Insyte-Technology/EFRO_Breast_Cancer_Detection/Minimal_Prototype_Function_Generator_V0.1/Minimal_Prototype_Function_Generator_V0.1.kicad_pcb

## KiCad design Minimal_Prototype_Function_Generator_V0.1/Minimal_Prototype_Function_Generator_V0.1.kicad_pcb (2025-12-15)

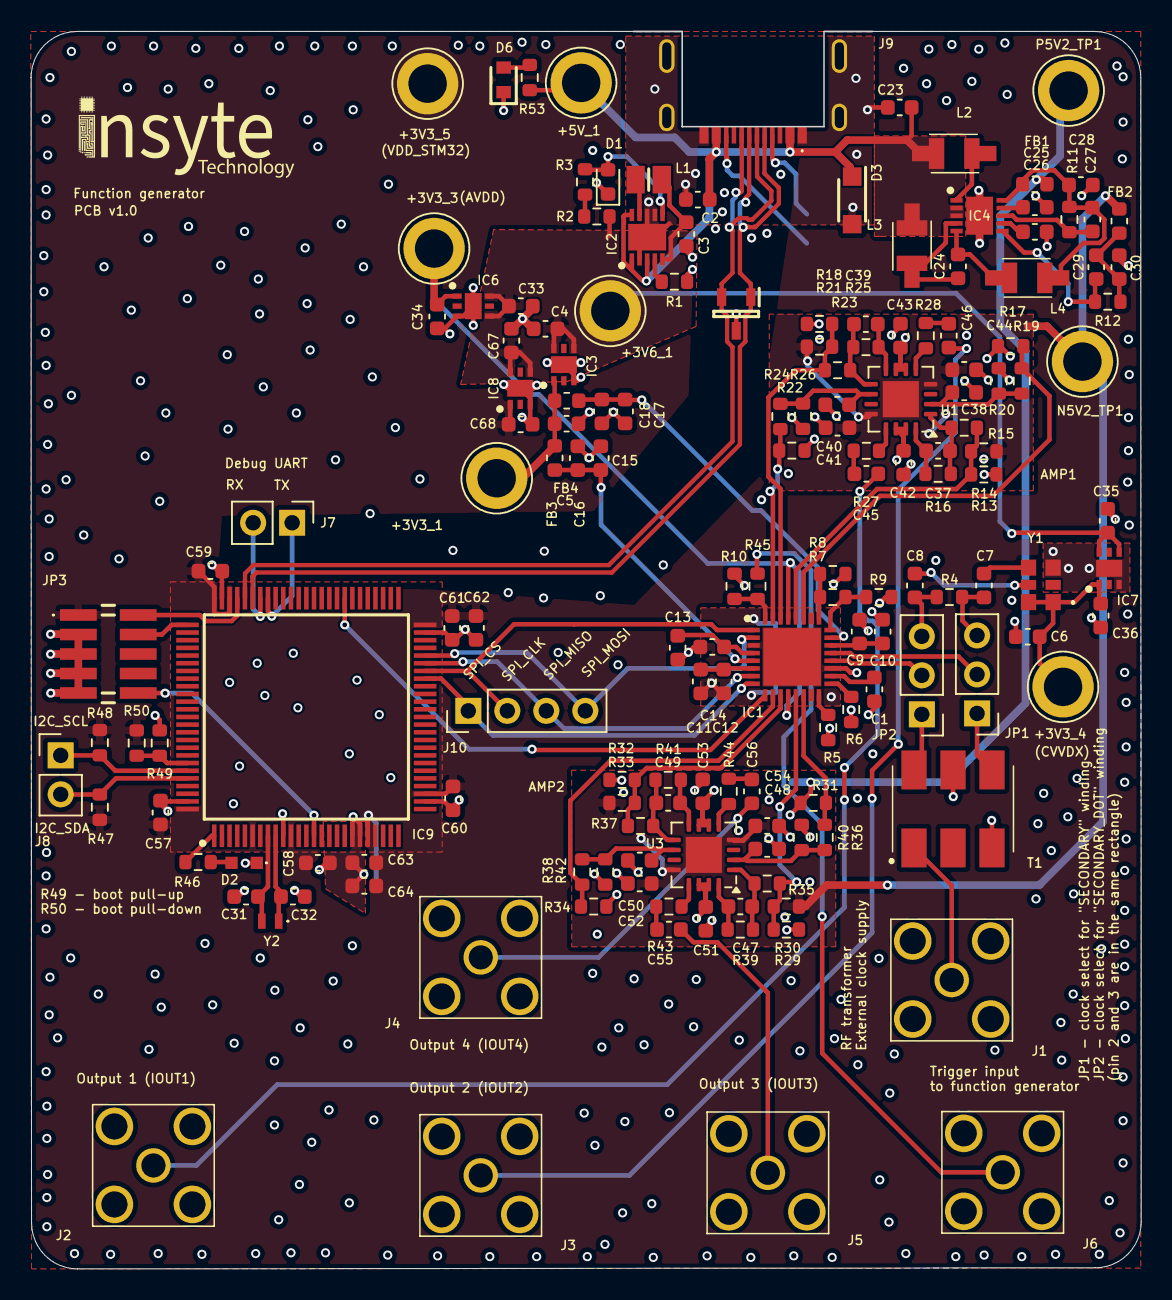
[picture p1: board Minimal_Prototype_Function_Generator_V0.1.kicad_pcb from above]

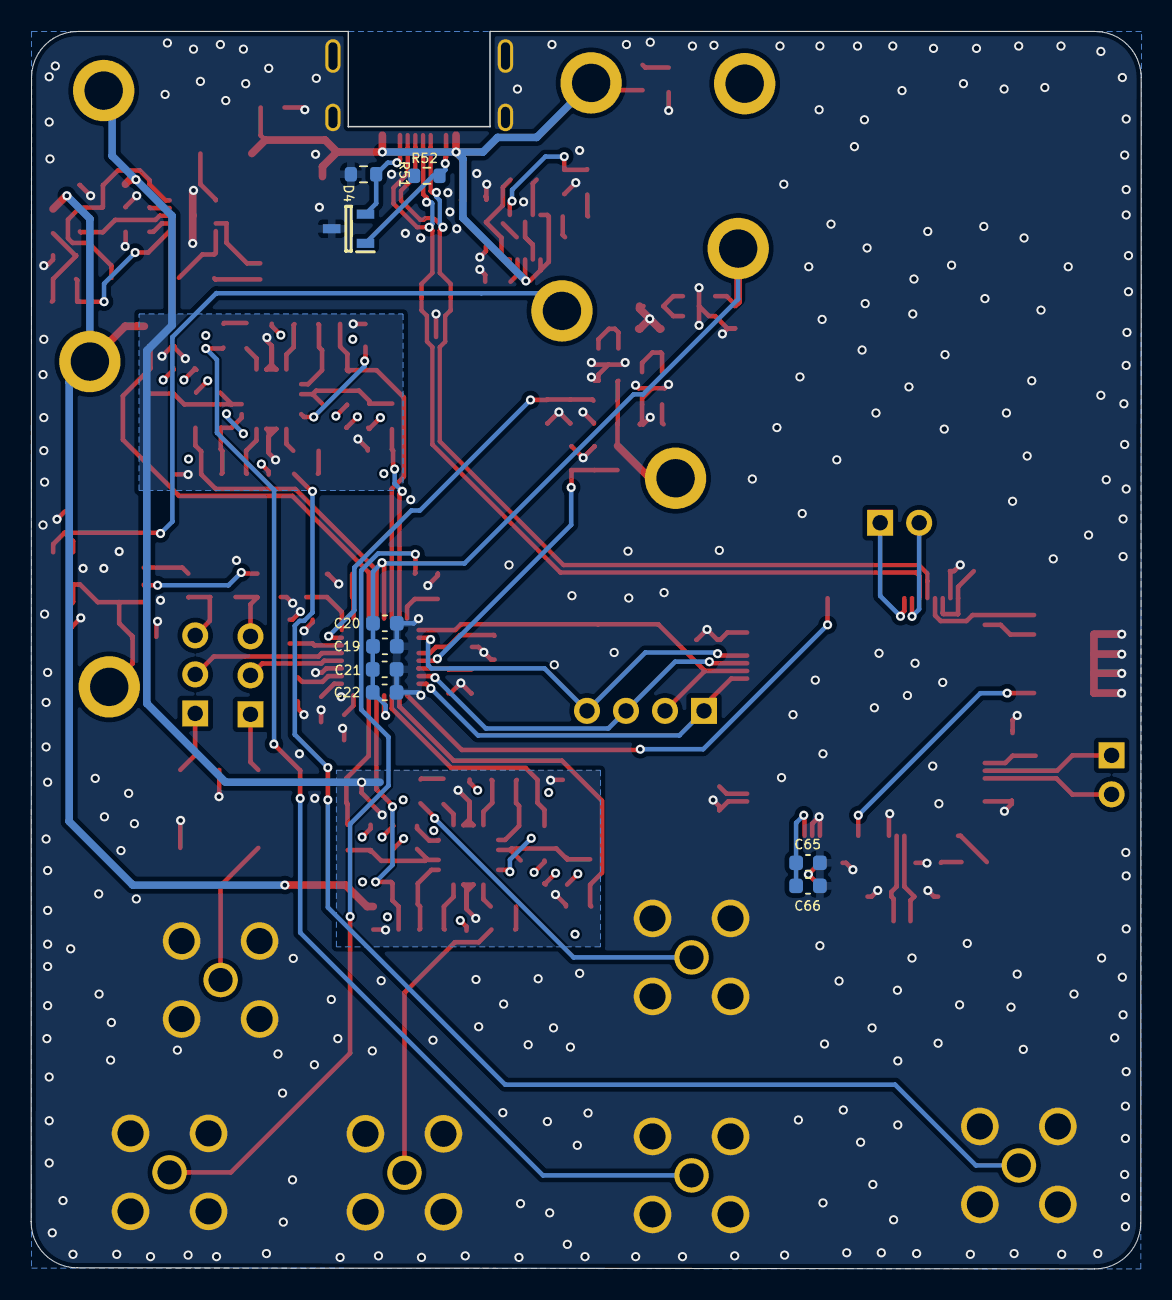
[picture p2: board Minimal_Prototype_Function_Generator_V0.1.kicad_pcb from below]

Board: 4 copper layers, 72.3 x 80.6 mm, 170 parts (9 on the bottom side), 97 nets.

Parts:
+3V3_1, +3V3_3, +3V3_4, +3V3_5, +3V6_1, +5V_1: TestPoint; TestPoint_Loop_D3.80mm_Drill2.5mm
C1, C6, C7, C8, C9, C11, C13, C15, C17, C19, C21, C25, C26, C41, C42, C43, C44, C51, C52, C53, C54: 0.1uF; C_0603_1608Metric
C2, C3: 10uF; C_0603_1608Metric
C4, C5, C33, C34, C35, C36, C67, C68: 4.7uF; C_0603_1608Metric
C10, C12, C16, C18, C20, C22: 100pF; C_0603_1608Metric
C14: 0.01uF; C_0603_1608Metric
C23, C28, C30: 2.2uF; C_0603_1608Metric
C24, C45, C46, C55, C56: 1uF; C_0603_1608Metric
C27: 4.7pF; C_0603_1608Metric
C29: 10pF; C_0603_1608Metric
C31, C32: 8pF C0G/NP0 >5%; C_0603_1608Metric
C37, C38, C39, C40, C47, C48, C49, C50: 1.5pF; C_0603_1608Metric
C57, C58, C59, C60, C61, C65: 0.1u; C_0603_1608Metric
C62: 4.7u; C_0603_1608Metric
C63: 0.01u; C_0603_1608Metric
C64, C66: 1u; C_0603_1608Metric
D1: LED GREEN; LED_0603_1608Metric
D2: CSL1901MW1
D3: SMF5.0A; SODFL3618X110N
D4, D5: SM05.TCT; SOT95P237X125-3N
D6: APT1608LZGCK; LEDC1608X85N
FB1, FB2, FB3, FB4: 1.8K OHM AT 100MEGHZ; L_0603_1608Metric
IC1: AD9106BCPZ; QFN50P500X500X80-33N-D
IC2: ADP5300ACPZ-1-R7; SON50P300X300X85-11N-D
IC3, IC6, IC7, IC8: ADM7160ACPZN3.3-R7; SON65P200X200X65-7N-D
IC4: LT3472EDD#PBF; SON50P300X300X80-11N-D
IC9: STM32L476VGT6; QFP50P1600X1600X160-100N
J1, J2, J3, J4, J5, J6: 142-0701-201; 1420701201
J7: DEBUG_UART_TP_1; PinHeader_1x02_P2.54mm_Vertical
J8: I2C_TP1; PinHeader_1x02_P2.54mm_Vertical
J9: USB4500-03-0-A; USB4500030A
J10: SPI_TP_1; PinHeader_1x04_P2.54mm_Vertical
JP1, JP2: Jumper_3_Open; PinHeader_1x03_P2.54mm_Vertical
JP3: 20021121-00010C4LF; 2002112100010C4LF
L1: MLP2016H2R2MT0S1; INDC2016X100N
L2: 22uH; LQH32CH100K53L
L3, L4: 47uH; LQH32CH100K53L
N5V2_TP1: TestPoint; TestPoint_Loop_D3.80mm_Drill2.5mm
P5V2_TP1: TestPoint; TestPoint_Loop_D3.80mm_Drill2.5mm
R1: 499K; R_0603_1608Metric
R2, R4: 100R; R_0603_1608Metric
R3, R7: 0R; R_0603_1608Metric
R5, R6, R8, R9: 8.06K; R_0603_1608Metric
R10: 9.1K; R_0603_1608Metric
R11: 158K; R_0603_1608Metric
R12: 210K; R_0603_1608Metric
R13, R14, R17, R18, R21, R22, R29, R30, R31, R32, R33, R34: 1K; R_0603_1608Metric
R15, R16, R19, R20, R23, R24, R25, R26, R35, R36, R37, R38, R39, R40, R41, R42: 499R; R_0603_1608Metric
R27, R28, R43, R44: 49.9R; R_0603_1608Metric
R45: 4.7K; R_0603_1608Metric
R46: 750; R_0603_1608Metric
R47, R48: 4K7; R_0603_1608Metric
R49, R50: 10K; R_0603_1608Metric
R51, R52: 5.1K; R_0603_1608Metric
R53: 325R; R_0603_1608Metric
T1: ADT2-1T+; ADT21T
U1, U3: ADA4817-2ACP; Analog_LFCSP-16-1EP_4x4mm_P0.65mm_EP2.35x2.35mm
U4: 15x6_Insyte_Logo
Y1: AX3DCF1-156.2500T; AX3_3.2x2.5
Y2: ECS-.327-7-16-C-TR; ECS327516TR

Connections:
/Function Generator/!RESET: IC1.9 (~RESET), IC9.58 (PD11)
/Function Generator/AVDD: +3V3_3.1, C19.1, C20.1, C21.1, C22.1, C34.1, IC1.12 (AVDD2), IC1.29 (AVDD1), IC6.1 (VOUT)
/Function Generator/CLKLDO: C9.1, C10.1, IC1.22 (CLDO)
/Function Generator/CLKN: IC1.20 (CLKN), JP2.2 (C)
/Function Generator/CLKP: IC1.21 (CLKP), JP1.2 (C)
/Function Generator/CLKVDD: C17.1, C18.1, FB4.2, IC1.23 (CLKVDD)
/Function Generator/CVDDX: +3V3_4.1, C6.1, C36.1, IC7.1 (VOUT), Y1.1 (E/D), Y1.6 (VDD)
/Function Generator/DLDO1: C11.1, C12.1, IC1.6 (DLDO1)
/Function Generator/DLDO2: C13.1, C14.1, IC1.4 (DLDO2)
/Function Generator/DVDD: C15.1, C16.1, FB3.2, IC1.5 (DVDD)
/Function Generator/I_Out_N1: IC1.28 (IOUTN1), R13.1, R14.2, R15.2
/Function Generator/I_Out_N2: IC1.30 (IOUTN2), R18.1, R21.2, R23.2
/Function Generator/I_Out_N3: IC1.13 (IOUTN3), R29.1, R30.2, R35.2
/Function Generator/I_Out_N4: IC1.11 (IOUTN4), R32.1, R33.2, R37.2
/Function Generator/I_Out_P1: IC1.27 (IOUTP1), R17.1, R19.2
/Function Generator/I_Out_P2: IC1.31 (IOUTP2), R22.1, R24.2
/Function Generator/I_Out_P3: IC1.14 (IOUTP3), R31.1, R36.2
/Function Generator/I_Out_P4: IC1.10 (IOUTP4), R34.1, R38.2
/Function Generator/SPI_CLK: IC1.1 (SCLK), IC9.44 (PE13), J10.2
/Function Generator/SPI_CS: IC1.8 (~CS), IC9.43 (PE12), J10.1
/Function Generator/SPI_MISO: IC1.7 (SDO/SDI2/DOUT), IC9.45 (PE14), J10.3
/Function Generator/SPI_MOSI: IC1.2 (SDIO), IC9.46 (PE15), J10.4
/Function Generator/Trigger_Input_3V3: IC1.32 (~TRIGGER), R10.2, R45.1
/Output_Stage/N5V2: C41.1, C44.1, C52.1, C54.1, FB2.2, N5V2_TP1.1, R14.1, R21.1, R30.1, R33.1, U1.4 (-V_{S}), U1.12 (-V_{S}), U1.17 (EP), U3.4 (-V_{S}), U3.12 (-V_{S}), U3.17 (EP)
/Output_Stage/Op_Amp_1/+IN_1: C38.1, R19.1, R20.1, U1.2 (+)
/Output_Stage/Op_Amp_1/+IN_2: C40.1, R24.1, R26.1, U1.10 (+)
/Output_Stage/Op_Amp_1/-IN_1: C37.1, R15.1, R16.1, U1.1 (-)
/Output_Stage/Op_Amp_1/-IN_2: C39.1, R23.1, R25.1, U1.9 (-)
/Output_Stage/Op_Amp_1/AMP1_OUT: C46.2, J3.1 (In)
/Output_Stage/Op_Amp_1/AMP_OUT: C45.2, J2.1 (In)
/Output_Stage/Op_Amp_1/FB_1: C37.2, R16.2, U1.16 (FB)
/Output_Stage/Op_Amp_1/FB_2: C39.2, R25.2, U1.8 (FB)
/Output_Stage/Op_Amp_2/+IN_1: C48.1, R36.1, R40.1, U3.2 (+)
/Output_Stage/Op_Amp_2/+IN_2: C50.1, R38.1, R42.1, U3.10 (+)
/Output_Stage/Op_Amp_2/-IN_1: C47.1, R35.1, R39.1, U3.1 (-)
/Output_Stage/Op_Amp_2/-IN_2: C49.1, R37.1, R41.1, U3.9 (-)
/Output_Stage/Op_Amp_2/AMP1_OUT: C56.2, J4.1 (In)
/Output_Stage/Op_Amp_2/AMP_OUT: C55.2, J5.1 (In)
/Output_Stage/Op_Amp_2/FB_1: C47.2, R39.2, U3.16 (FB)
/Output_Stage/Op_Amp_2/FB_2: C49.2, R41.2, U3.8 (FB)
/Output_Stage/P5V2: C42.2, C43.2, C51.2, C53.2, FB1.2, P5V2_TP1.1, R13.2, R17.2, R18.2, R22.2, R29.2, R31.2, R32.2, R34.2, U1.6 (+V_{S}), U1.7 (~PD), U1.14 (+V_{S}), U1.15 (~PD), U3.6 (+V_{S}), U3.7 (~PD), U3.14 (+V_{S}), U3.15 (~PD)
/Power/5V: +5V_1.1, C2.1, C23.1, D3.1 (K), IC2.1 (EN), IC2.3 (SYNC/MODE), IC2.10 (PVIN), IC4.2 (VIN), IC4.3 (~SHDN), J9.A4 (VBUS_1), J9.A9 (VBUS_2), L2.1, L2.3, L3.2, L3.4, R53.1
/Power/ADM7160ACPZN3.3_1/+3V3: +3V3_1.1, C5.1, FB3.1, FB4.1, IC3.1 (VOUT)
/Power/ADM7160ACPZN3.3_1/+3V6: +3V6_1.1, C3.1, C4.1, C33.1, C35.1, C67.1, IC2.5 (FB), IC3.4 (EN), IC3.6 (VIN), IC6.4 (EN), IC6.6 (VIN), IC7.4 (EN), IC7.6 (VIN), IC8.4 (EN), IC8.6 (VIN), L1.2, R2.1
/Power/LT3472EDD/N5V2_VN: C29.2, C30.1, FB2.1, R12.2
/Power/LT3472EDD/P5V2_VP: C27.2, C28.1, FB1.1, IC4.10 (VPOS), L4.1, L4.3, R11.2
/Power/VDD_STM32: +3V3_5.1, C57.1, C58.1, C59.1, C60.1, C61.1, C62.1, C63.1, C64.1, C65.1, C66.1, C68.1, IC8.1 (VOUT), IC9.6 (VBAT), IC9.11 (VDD_1), IC9.21 (VREF+), IC9.22 (VDDA), IC9.28 (VDD_2), IC9.50 (VDD_3), IC9.73 (VDDUSB), IC9.75 (VDD_4), IC9.100 (VDD_5), JP3.1, R47.1, R48.1, R50.1
/STM32/I2C_SCL: IC9.95 (PB8), J8.1, R48.2
/STM32/I2C_SDA: IC9.96 (PB9), J8.2, R47.2
/STM32/NRST: IC9.14 (NRST), JP3.10
/STM32/SWCLK: IC9.76 (PA14), JP3.4
/STM32/SWDIO: IC9.72 (PA13), JP3.2
/USB_C/CC1: D4.2 (K), J9.A5 (CC1), R51.1
/USB_C/CC2: D4.1 (K), J9.B5 (CC2), R52.1
/USB_C/D+: D5.2 (K), IC9.71 (PA12), J9.A6 (DP1), J9.B6 (DP2)
/USB_C/D-: D5.1 (K), IC9.70 (PA11), J9.A7 (DN1), J9.B7 (DN2)
GND: C1.2, C2.2, C3.2, C4.2, C5.2, C6.2, C9.2, C10.2, C11.2, C12.2, C13.2, C14.2, C15.2, C16.2, C17.2, C18.2, C19.2, C20.2, C21.2, C22.2, C23.2, C25.2, C26.2, C28.2, C30.2, C31.1, C32.1, C33.2, C34.2, C35.2, C36.2, C38.2, C40.2, C41.2, C42.1, C43.1, C44.2, C48.2, C50.2, C51.1, C52.2, C53.1, C54.2, C57.2, C58.2, C59.2, C60.2, C61.2, C62.2, C63.2, C64.2, C65.2, C66.2, C67.2, C68.2, D1.1 (K), D2.1 (K), D3.2 (A), D4.3 (A), D5.3 (A), D6.1 (K), IC1.3 (DGND), IC1.15 (AGND_1), IC1.19 (CLKGND), IC1.26 (AGND_2), IC1.33 (GND), IC2.2 (STOP), IC2.7 (AGND), IC2.8 (PGND), IC2.11 (EP), IC3.3 (GND), IC3.7 (EP), IC4.11 (EP), IC6.3 (GND), IC6.7 (EP), IC7.3 (GND), IC7.7 (EP), IC8.3 (GND), IC8.7 (EP), IC9.10 (VSS_1), IC9.19 (VSSA), IC9.20 (VREF-), IC9.27 (VSS_2), IC9.49 (VSS_3), IC9.74 (VSS_4), IC9.99 (VSS_5), J1.2 (Ext), J1.3 (Ext), J1.4 (Ext), J1.5 (Ext), J2.2 (Ext), J2.3 (Ext), J2.4 (Ext), J2.5 (Ext), J3.2 (Ext), J3.3 (Ext), J3.4 (Ext), J3.5 (Ext), J4.2 (Ext), J4.3 (Ext), J4.4 (Ext), J4.5 (Ext), J5.2 (Ext), J5.3 (Ext), J5.4 (Ext), J5.5 (Ext), J6.2 (Ext), J6.3 (Ext), J6.4 (Ext), J6.5 (Ext), J9.A1 (GND_1), J9.A12 (GND_2), J9.MH1, J9.MH2, J9.MH3, J9.MH4, JP3.3, JP3.5, JP3.7, JP3.9, R1.2, R5.2, R6.2, R8.1, R9.1, R10.1, R20.2, R26.2, R40.2, R42.2, R49.2, R51.2, R52.2, T1.3 (PRIMARY_DOT), T1.5 (SECONDARY_CT), Y1.3 (GND)
unnamed: C45.1, R27.1
unnamed: C46.1, R28.1
unnamed: C55.1, R43.1
unnamed: C56.1, R44.1
unnamed: D1.2 (A), IC2.6 (VOUTOK), R3.2
unnamed: D2.2 (A), R46.2
unnamed: D6.2 (A), R53.2
unnamed: IC1.25 (FSADJ1), R7.1, R8.2
unnamed: IC1.24 (FSADJ2/CAL_SENSE), R7.2, R9.2
unnamed: IC1.16 (FSADJ3), R5.1
unnamed: IC1.17 (FSADJ4), R6.1
unnamed: C1.1, IC1.18 (REFIO)
unnamed: IC2.9 (SW), L1.1
unnamed: IC2.4 (VID), R1.1
unnamed: C24.2, IC4.5 (DN), L4.2, L4.4
unnamed: C29.1, IC4.6 (FBN), R12.1
unnamed: C27.1, IC4.8 (FBP), R11.1
unnamed: C26.1, IC4.7 (SSN)
unnamed: C25.1, IC4.9 (SSP)
unnamed: C24.1, IC4.4 (SWN), L3.1, L3.3
unnamed: IC4.1 (SWP), L2.2, L2.4
unnamed: IC9.94 (BOOT0), R49.1, R50.2
unnamed: IC9.68 (PA9), J7.1
unnamed: IC9.69 (PA10), J7.2
unnamed: C31.2, IC9.8 (PC14/OSC32_IN), Y2.2 (OUT/IN)
unnamed: C32.2, IC9.9 (PC15/OSC32_OUT), Y2.1
unnamed: IC9.1 (PE2), R46.1
unnamed: J1.1 (In), T1.1 (PRIMARY)
unnamed: J6.1 (In), R45.2
unnamed: JP1.1 (A), T1.4 (SECONDARY)
unnamed: C7.2, JP1.3 (B), R4.1
unnamed: JP2.1 (A), T1.6 (SECONDARY_DOT)
unnamed: C8.2, JP2.3 (B), R4.2
unnamed: R2.2, R3.1
unnamed: R27.2, U1.13
unnamed: R28.2, U1.5
unnamed: R43.2, U3.13
unnamed: R44.2, U3.5
unnamed: C8.1, Y1.5 (COMP_OUT)
unnamed: C7.1, Y1.4 (OUTPUT)
