Insyte-Technology/EFRO_Breast_Cancer_Detection/Software/Core/Src/main.c

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
/* Includes ------------------------------------------------------------------*/
#include "main.h"
#include "i2c.h"
#include "spi.h"
#include "usart.h"
#include "usb_device.h"
#include "gpio.h"
#include "usbd_cdc_if.h"
#include "ad9106.h"
#include "cli.h"


void SystemClock_Config(void);
/**
 * @brief  The application entry point.
 * @retval int
 */
int main(void)
{

  /* MCU Configuration--------------------------------------------------------*/

  /* Reset of all peripherals, Initializes the Flash interface and the Systick. */
  HAL_Init();

  /* Configure the system clock */
  SystemClock_Config();

  /* Initialize all configured peripherals */
  MX_GPIO_Init();
  MX_SPI1_Init();
  MX_USART1_UART_Init();
  MX_USB_DEVICE_Init();
  MX_I2C1_Init();
  /* USER CODE BEGIN 2 */

  HAL_Delay(200);

  HAL_GPIO_WritePin(SPI_CS_GPIO_Port, SPI_CS_Pin, GPIO_PIN_SET);
  HAL_GPIO_WritePin(LED_GPIO_Port, LED_Pin, GPIO_PIN_SET);

  AD9106_Init();
  AD9106_Reset();
  CLI_Init();

  // 2. Configure registers
  /*
    // (a) Power configuration: disable DAC1, DAC2, DAC4 (sleep), keep DAC3 active
    AD9106_WriteReg(0x01, 0b0000000000001101); // DAC1_SLEEP, DAC2_SLEEP, DAC4_SLEEP = 1

    HAL_Delay(10);

    AD9106_ReadReg(0x01);

    HAL_Delay(10);
    // (b) DDS tuning word (sets output frequency)
    AD9106_WriteReg(0x3E, 0x0000); // DDS_TW32 (MSB)

    HAL_Delay(10);
    AD9106_WriteReg(0x3F, 0xFF00); // DDS_TW1  (LSB) → Tuning word = 0x00A300

    HAL_Delay(10);

    AD9106_ReadReg(0x3F);
    HAL_Delay(10);
    // (c) Select waveform source for DAC3 = DDS
    AD9106_WriteReg(0x26, 0x0300); // PRESTORE_SEL3 = 3 (DDS), WAVE_SEL3 = 0 (prestored waveform)
    HAL_Delay(10);
    // (d) Set unity digital gain for DAC3
    AD9106_WriteReg(0x33, 0x0400); // DAC3_DGAIN = +1.0
    HAL_Delay(10);
    // (f) Enable pattern generator
    AD9106_WriteReg(0x1E, 0x0001); // RUN = 1
    HAL_Delay(10);
    AD9106_ReadReg(0x1E);
    HAL_Delay(10);
    // (e) Update all configuration shadow registers
    AD9106_WriteReg(0x1D, 0x0001); // RAMUPDATE = 1
    HAL_Delay(10);


  uint16_t AD910x_SPI_Register_Addresses[66] = {0x0000, 0x0001, 0x0002, 0x0003, 0x0004, 0x0005, 0x0006, 0x0007, 0x0008, 0x0009, 0x000a, 0x000b, 0x000c, 0x000d, 0x000e, 0x001f, 0x0020, 0x0022, 0x0023, 0x0024, 0x0025, 0x0026, 0x0027, 0x0028, 0x0029, 0x002a, 0x002b, 0x002c, 0x002d, 0x002e, 0x002f, 0x0030, 0x0031, 0x0032, 0x0033, 0x0034, 0x0035, 0x0036, 0x0037, 0x003e, 0x003f, 0x0040, 0x0041, 0x0042, 0x0043, 0x0044, 0x0045, 0x0047, 0x0050, 0x0051, 0x0052, 0x0053, 0x0054, 0x0055, 0x0056, 0x0057, 0x0058, 0x0059, 0x005a, 0x005b, 0x005c, 0x005d, 0x005e, 0x005f, 0x001e, 0x001d};
  uint16_t AD9106_example3_regval[66] = {0x0000, 0x0e00, 0x0000, 0x0000, 0x4000, 0x4000, 0x4000, 0x4000, 0x0000, 0x1f00, 0x1f00, 0x1f00, 0x1f00, 0x0000, 0x0000, 0x0000, 0x000e, 0x0000, 0x0000, 0x0000, 0x0000, 0x3232, 0x3232, 0x0111, 0xffff, 0x0101, 0x0101, 0x0003, 0x0000, 0x0000, 0x0000, 0x0000, 0x0000, 0x4000, 0x2000, 0x2000, 0x4000, 0x0001, 0x0200, 0x0a3d, 0x7100, 0x0000, 0x0000, 0x0000, 0x0000, 0x0000, 0x0000, 0x0000, 0x07d0, 0x0000, 0x0000, 0x0100, 0x03e8, 0x0000, 0x0000, 0x0100, 0x0bb8, 0x0000, 0x0000, 0x0100, 0x0fa0, 0x0000, 0x0000, 0x0100, 0x0001, 0x0001};
  uint16_t AD9106_example4_regval[66] = {0x0000, 0x0e00, 0x0000, 0x0000, 0x4000, 0x4000, 0x4000, 0x4000, 0x0000, 0x1f00, 0x1f00, 0x1f00, 0x1f00, 0x0000, 0x0000, 0x0000, 0x000e, 0x0000, 0x0000, 0x0000, 0x0000, 0x1212, 0x1232, 0x0121, 0xffff, 0x0101, 0x0101, 0x0003, 0x0000, 0x0000, 0x0000, 0x0000, 0x0000, 0x4000, 0x4000, 0x4000, 0x4000, 0x1011, 0x0600, 0x1999, 0x9a00, 0x0000, 0x0000, 0x0000, 0x0000, 0x0000, 0x0000, 0x0000, 0x07d0, 0x0000, 0x0000, 0x0001, 0x03e8, 0x0000, 0x0000, 0x0001, 0x03e8, 0x0000, 0x0000, 0x0001, 0x0fa0, 0x0000, 0x0000, 0x16ff, 0x0001, 0x0001};
  uint16_t AD9106_example6_regval[66] = {0x0000, 0x0e00, 0x0000, 0x0000, 0x4000, 0x4000, 0x4000, 0x4000, 0x0000, 0x1f00, 0x1f00, 0x1f00, 0x1f00, 0x0000, 0x0000, 0x0000, 0x000e, 0x0000, 0x0000, 0x0000, 0x0000, 0x1212, 0x1232, 0x0111, 0xffff, 0x0101, 0x0101, 0x0003, 0x0000, 0x0000, 0x0000, 0x0000, 0x0000, 0x4000, 0x4000, 0x4000, 0x4000, 0x0001, 0x7e00, 0x0750, 0x7500, 0x0000, 0x0000, 0x0000, 0x0000, 0x0002, 0x0000, 0x0000, 0x2710, 0x0000, 0x0000, 0x0001, 0x0000, 0x0000, 0x0000, 0x0001, 0x1770, 0x0000, 0x0000, 0x0001, 0x0fa0, 0x0000, 0x0000, 0x7fff, 0x0001, 0x0001};

  for (int i = 0; i < 66; i++)
  {
    AD9106_WriteReg(AD910x_SPI_Register_Addresses[i], AD9106_example4_regval[i]);
    AD9106_ReadReg(AD910x_SPI_Register_Addresses[i]);

    HAL_Delay(10);
  }

   */

  /* USER CODE END 2 */

  /* Infinite loop */
  /* USER CODE BEGIN WHILE */
  while (1)
  {

    CLI_Process();
    HAL_Delay(1);
    /* USER CODE END WHILE */

    /* USER CODE BEGIN 3 */
  }
  /* USER CODE END 3 */
}

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
