Insyte-Technology/EFRO_Breast_Cancer_Detection/Software/Function_Generator_V0.1.ioc

Mcu.UserName=STM32L476VGTx
PA10.Signal=USART1_RX
PA11.Signal=USB_OTG_FS_DM
PA12.Signal=USB_OTG_FS_DP
PA9.Signal=USART1_TX
PB8.Signal=I2C1_SCL
PB9.Signal=I2C1_SDA
PD11.GPIO_Label=FUNC_RESET
PD11.Signal=GPIO_Output
PE12.GPIO_Label=SPI_CS
PE12.Signal=GPIO_Output
PE13.Signal=SPI1_SCK
PE14.Signal=SPI1_MISO
PE15.Signal=SPI1_MOSI
PE2.GPIO_Label=LED
PE2.Signal=GPIO_Output
