Insyte-Technology/EFRO_Breast_Cancer_Detection/Software/Core/Inc/main.h

#define LED_Pin GPIO_PIN_2
#define LED_GPIO_Port GPIOE
#define SPI_CS_Pin GPIO_PIN_12
#define SPI_CS_GPIO_Port GPIOE
#define FUNC_RESET_Pin GPIO_PIN_11
#define FUNC_RESET_GPIO_Port GPIOD
