Insyte-Technology/EFRO_Breast_Cancer_Detection/(notices)

Notices in the files:
Software/Core/Inc/main.h:
Copyright (c) 2025 STMicroelectronics.
All rights reserved.
This software is licensed under terms that can be found in the LICENSE file
